sipeed/RV-Debugger-BL702/(threads)

Thread 1 (2021-07-21):

如何调试bl602呢

HoGC, 2021-07-21:
使用RV-Debugger-BL702对bl602进行调试，但是在打开OpenOCD时得到了`IR capture error at bit 5, saw 0x01 not 0x...3`的错误
```
Open On-Chip Debugger 0.10.0+dev (SiFive OpenOCD 0.10.0-2019.08.2)
Licensed under GNU GPL v2
For bug reports:
        https://github.com/sifive/freedom-tools/issues
adapter speed: 2000 kHz
Ready for Remote Connections
Info : clock speed 2000 kHz
Info : JTAG tap: riscv.cpu tap/device found: 0x20000c05 (mfg: 0x602 (<unknown>), part: 0x0000, ver: 0x2)
Error: IR capture error at bit 5, saw 0x01 not 0x...3
Warn : Bypassing JTAG setup events due to errors
Error: failed write at 0x10, status=1
Error: failed write at 0x10, status=1
Error: failed write at 0x10, status=1
Error: failed read at 0x10, status=1
Info : Listening on port 3333 for gdb connections
Info : Listening on port 6666 for tcl connections
Info : Listening on port 4444 for telnet connections
```

Thread 6 (2022-01-20):

Rv BL702 can't connect to target over Openocd

thinhx2, 2022-01-20:
It still stuck at : haven't made progress in mpsse flash()

Rv BL702(programmer)
![Uploading IMG_20220120_194508_489.jpg…]()
+ openocd 0.11 + STM32F103 (target)

RV lite CH552T working fine

thinhx2, 2022-01-20:
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

Here is image

thinhx2, 2022-01-20:
Error notice when i remove programmer, not problem

thinhx2, 2022-01-22:
'/home/thinhx2/xpack-openocd-0.11.0-3/bin/openocd'  -f '/home/thinhx2/Desktop/tool-openocd-gd32v/share/openocd/scripts/interface/ftdi/sipeed-rv-debugger.cfg'  -f '/home/thinhx2/xpack-openocd-0.11.0-3/scripts/target/stm32f1x.cfg' -c "adapter speed 1000" -c "init;program /media/thinhx2/A44CFDC04CFD8CF4/Users/thinhx2/Documents/32/103c8/build/103c8.hex verify reset;exit"
xPack OpenOCD x86_64 Open On-Chip Debugger 0.11.0+dev (2021-12-07-17:30)
Licensed under GNU GPL v2
For bug reports, read
	http://openocd.org/doc/doxygen/bugs.html
DEPRECATED! use 'adapter driver' not 'interface'
DEPRECATED! use 'ftdi vid_pid' not 'ftdi_vid_pid'
DEPRECATED! use 'ftdi layout_init' not 'ftdi_layout_init'
DEPRECATED! use 'ftdi layout_signal' not 'ftdi_layout_signal'
Info : DEPRECATED target event trace-config; use TPIU events {pre,post}-{enable,disable}
adapter speed: 1000 kHz

Info : clock speed 1000 kHz
Warn : Haven't made progress in mpsse_flush() for 2001ms.
Warn : Haven't made progress in mpsse_flush() for 4001ms.
Warn : Haven't made progress in mpsse_flush() for 8001ms.
Warn : Haven't made progress in mpsse_flush() for 16001ms.
Warn : Haven't made progress in mpsse_flush() for 32001ms.

thinhx2, 2022-01-22:
Seem like with target command  (like stm32f1x.cfg) debugger will disconnect. Same problem with platformIO, Longan Nano

Closed 2022-01-22.

Thread 8 (2022-02-01):

USB enumeration issues

chiplet, 2022-02-01:
I'm experiencing USB enumeration issues on the Tang Nano 1K, 4K, and 9K boards. It seems that they use the same chip and presumably also the same firmware as this project so I'm reporting it here. Correct me if I'm wrong.

The problem is that when I try to connect the programmer to my computer over a USB hub, it fails to enumerate.

```
[29332.909014] usb 7-1.2: new full-speed USB device number 8 using xhci_hcd
[29338.196264] usb 7-1.2: device descriptor read/64, error -71
[29343.532540] usb 7-1.2: device descriptor read/64, error -71
[29343.722499] usb 7-1.2: new full-speed USB device number 9 using xhci_hcd
[29348.862626] usb 7-1.2: device descriptor read/64, error -71
[29354.196037] usb 7-1.2: device descriptor read/64, error -71
[29354.302915] usb 7-1-port2: attempt power cycle
[29354.916045] usb 7-1.2: new full-speed USB device number 10 using xhci_hcd
[29360.086242] xhci_hcd 0000:0a:00.3: Timeout while waiting for setup device command
[29365.419676] xhci_hcd 0000:0a:00.3: Timeout while waiting for setup device command
[29365.626240] usb 7-1.2: device not accepting address 10, error -62
[29365.709582] usb 7-1.2: new full-speed USB device number 11 using xhci_hcd
[29365.709791] usb 7-1.2: Device not responding to setup address.
[29365.916323] usb 7-1.2: Device not responding to setup address.
[29366.123016] usb 7-1.2: device not accepting address 11, error -71
[29366.123294] usb 7-1-port2: unable to enumerate USB device
```

This also happens on the front-panel USB hubs if there are other USB devices connected to the adjacent ports. However, if I unplug all other devices from the front panel it successfully enumerates again.

Enumeration works fine when directly connecting to USB ports in the motherboard.

I haven't experienced any enumeration issues with my other USB devices on these hubs so it seems like the issue related to the BL702 implementation.

securez, 2024-09-15:
Hi, the last time I checked it, seems to be related with the USB bMaxPower configuration, seems to be set at 90mA, It's a bit low for power up Tang Nano 4K I thing. I can test if the change solves the problem, but seems to me that this repository is stalled for a long time. If he project is dead I don't want to waste my time if nobody is reviewing the PR and resolving the issues.

CheemsThx, 2025-03-25:
有没有可能是USB硬件设计问题,阻抗没做好匹配导致抗干扰性能太差

Thread 11 (2022-04-24):

No Setup/Hold time on TDI / TMS

GideonZ, 2022-04-24:
With my purchased Sipeed RV Debugger Plus, which seems to use this firmware, I am not getting any successful JTAG connection using OpenOCD.

One issue is that the setup and hold times on TDI and TMS are near zero. This is wrong!

TDI and TCK toggle AT THE SAME TIME. Even more so, TDI / TMS also change on the falling edge of TCK.  I did not expect this, and it is highly suspicious.

Please fix, as this adapter is totally unusable with a timing like this.

robertlipe, 2022-05-12:
** This is a fly-by comment. I don't technically contain any relevant experience with this project, except as a user. (They work OK on the devices I've used...) I was looking at the source and something caught my eye that may be relevant.

In the main source directory of this app, there are two versions of the source code for the main application. I think they share a common ancestor, but it's not clear which is the newest or what the hardware actually shipped with. Just reading the code and the git history, the trunk contains a newer version (10 months vs. 11) of that main app that works hard to avoid code that *was* there that added delays in transitions like this.

Try replacing [jtag_process.c](https://github.com/sipeed/RV-Debugger-BL702/blob/main/examples/usb/usb2uartjtag/jtag_process.c) with jtag_process.c.gowin. There are a lot of changes, but all that DELAY stuff that is missing might actually be helpful to this case.  It's uncomfortable to busy-wait in an interrupt handler, but that interrupt handler should be most of what that device is doing. It'd cause USB and serial overruns, but it shouldn't be DOING either of those while JTAGGing, right?

Maybe you graft those definitions and uses into the trunk and create a PR.

At the very least, these DELAY_HIGH and DELAY_LOW call sites mark the places in the code create edges in those signals when starting and ending transitions, so it may be helpful to add yet more delays.

Sidebar: you may find #3 handy.

Good luck.

Thread 12 (2022-04-24):

OpenOCD: No progress with mpsse_flush( )

GideonZ, 2022-04-24:
The mpsse implementation seems to be buggy. I cannot get this adapter to reliably work with OpenOCD. At times OpenOCD just hangs with the message "Haven't made progress in mpsse_flush()..."

This seems to happen more with OpenOCD 0.11.0-4, but I have also seen it happen with 0.10.0, which comes with Ubuntu (18.04 LTS).

robertlipe, 2022-05-12:
For a way to reliably crash the device (admittedly a slightly different BL602...) see https://bbs.bouffalolab.com/d/118-restore-bl706-evb-mb-ability-to-upload-code/8 for a similar report.

I don't suspect this lands on Sipeed as much as it does Bouffalo and/or OpenOCD.

zqb-all, 2023-02-21:
openocd log:
```
Debug: 14 30 command.c:166 script_debug(): command - adapter driver ftdi
Debug: 15 31 command.c:166 script_debug(): command - ftdi vid_pid 0x0403 0x6010
Debug: 16 35 command.c:166 script_debug(): command - transport select jtag
Debug: 17 36 command.c:166 script_debug(): command - ftdi layout_init 0x0008 0x001b
Debug: 18 38 command.c:166 script_debug(): command - ftdi layout_signal nSRST -oe 0x0020 -data 0x0020
Debug: 19 39 command.c:166 script_debug(): command - adapter speed 1200
Debug: 20 40 adapter.c:176 adapter_config_khz(): handle adapter khz
Debug: 21 41 adapter.c:140 adapter_khz_to_speed(): convert khz to adapter specific speed value
Debug: 22 43 adapter.c:140 adapter_khz_to_speed(): convert khz to adapter specific speed value
Debug: 23 44 command.c:166 script_debug(): command - bindto 0.0.0.0
Debug: 24 45 command.c:166 script_debug(): command - gdb_port 1025
Debug: 25 46 command.c:166 script_debug(): command - jtag newtap riscv cpu -irlen 5 -expected-id 0x10000BF6
Debug: 26 50 tcl.c:568 jim_newtap_cmd(): Creating New Tap, Chip: riscv, Tap: cpu, Dotted: riscv.cpu, 4 params
Debug: 27 52 tcl.c:593 jim_newtap_cmd(): Processing option: -irlen
Debug: 28 53 tcl.c:593 jim_newtap_cmd(): Processing option: -expected-id
Debug: 29 54 core.c:1468 jtag_tap_init(): Created Tap: riscv.cpu @ abs position 0, irlen 5, capture: 0x1 mask: 0x3
Debug: 30 56 command.c:166 script_debug(): command - target create riscv.cpu.0 riscv -chain-position riscv.cpu
Debug: 31 57 target.c:2214 target_free_all_working_areas_restore(): freeing all working areas
Debug: 32 59 riscv.c:356 riscv_create_target(): riscv_create_target()
Debug: 33 60 command.c:166 script_debug(): command - riscv.cpu.0 configure -work-area-phys 0x20000000 -work-area-size 4096 -work-area-backup 0
Debug: 34 64 target.c:2214 target_free_all_working_areas_restore(): freeing all working areas
Debug: 35 66 target.c:2214 target_free_all_working_areas_restore(): freeing all working areas
Debug: 36 67 target.c:2214 target_free_all_working_areas_restore(): freeing all working areas
Debug: 37 68 command.c:166 script_debug(): command - init
Debug: 38 69 command.c:166 script_debug(): command - target init
Debug: 39 70 command.c:166 script_debug(): command - target names
Debug: 40 71 command.c:166 script_debug(): command - riscv.cpu.0 cget -event gdb-flash-erase-start
Debug: 41 72 command.c:166 script_debug(): command - riscv.cpu.0 configure -event gdb-flash-erase-start reset init
Debug: 42 74 command.c:166 script_debug(): command - riscv.cpu.0 cget -event gdb-flash-write-end
Debug: 43 76 command.c:166 script_debug(): command - riscv.cpu.0 configure -event gdb-flash-write-end reset halt
Debug: 44 80 command.c:166 script_debug(): command - riscv.cpu.0 cget -event gdb-attach
Debug: 45 81 command.c:166 script_debug(): command - riscv.cpu.0 configure -event gdb-attach halt 1000
Debug: 46 83 target.c:1671 handle_target_init_command(): Initializing targets...
Debug: 47 84 riscv.c:369 riscv_init_target(): riscv_init_target()
Debug: 48 85 semihosting_common.c:130 semihosting_common_init():
Debug: 49 86 ftdi.c:742 ftdi_initialize(): ftdi interface using shortest path jtag state transitions
Debug: 50 110 mpsse.c:423 mpsse_purge(): -
Debug: 51 111 mpsse.c:704 mpsse_loopback_config(): off
Debug: 52 112 mpsse.c:749 mpsse_set_frequency(): target 1200000 Hz
Debug: 53 113 mpsse.c:710 mpsse_set_divisor(): 4
Debug: 54 114 mpsse.c:773 mpsse_set_frequency(): actually 1200000 Hz
Debug: 55 115 adapter.c:140 adapter_khz_to_speed(): convert khz to adapter specific speed value
Debug: 56 116 adapter.c:144 adapter_khz_to_speed(): have adapter set up
Debug: 57 118 mpsse.c:749 mpsse_set_frequency(): target 1200000 Hz
Debug: 58 119 mpsse.c:710 mpsse_set_divisor(): 4
Debug: 59 119 mpsse.c:773 mpsse_set_frequency(): actually 1200000 Hz
Debug: 60 120 adapter.c:140 adapter_khz_to_speed(): convert khz to adapter specific speed value
Debug: 61 122 adapter.c:144 adapter_khz_to_speed(): have adapter set up
Info : 62 123 adapter.c:104 adapter_init(): clock speed 1200 kHz
Debug: 63 126 openocd.c:143 handle_init_command(): Debug Adapter init complete
Debug: 64 127 command.c:166 script_debug(): command - transport init
Debug: 65 128 transport.c:230 handle_transport_init(): handle_transport_init
Debug: 66 130 core.c:824 jtag_add_reset(): SRST line released
Debug: 67 130 core.c:849 jtag_add_reset(): TRST line released
Debug: 68 131 core.c:322 jtag_call_event_callbacks(): jtag event: TAP reset
Debug: 69 133 command.c:166 script_debug(): command - jtag arp_init
Debug: 70 134 target.c:1857 target_call_event_callbacks(): target event 0 (gdb-halt) for core riscv.cpu.0
Debug: 71 135 target.c:3072 handle_target(): [riscv.cpu.0] target_poll() -> -4, next attempt in 100ms
Debug: 72 137 core.c:1503 jtag_init_inner(): Init JTAG chain
Debug: 73 137 core.c:322 jtag_call_event_callbacks(): jtag event: TAP reset
Debug: 74 139 core.c:1228 jtag_examine_chain(): DR scan interrogation for IDCODE/BYPASS
Debug: 75 142 core.c:322 jtag_call_event_callbacks(): jtag event: TAP reset
Warn : 76 2144 mpsse.c:917 mpsse_flush(): Haven't made progress in mpsse_flush() for 2001ms.
Warn : 77 4144 mpsse.c:917 mpsse_flush(): Haven't made progress in mpsse_flush() for 4001ms.
Warn : 78 8144 mpsse.c:917 mpsse_flush(): Haven't made progress in mpsse_flush() for 8001ms.
Warn : 79 16144 mpsse.c:917 mpsse_flush(): Haven't made progress in mpsse_flush() for 16001ms.
Warn : 80 32144 mpsse.c:917 mpsse_flush(): Haven't made progress in mpsse_flush() for 32001ms.
Warn : 81 64144 mpsse.c:917 mpsse_flush(): Haven't made progress in mpsse_flush() for 64001ms.
Warn : 82 128144 mpsse.c:917 mpsse_flush(): Haven't made progress in mpsse_flush() for 128001ms.
```

sipeed usb-jtag/ttl and sipeed rv-debugger lite can work, only sipeed rv-debugger plus have this issue.

Can anyone give me some advice?

GideonZ, 2023-02-21:
I had the same issue. I also measured the JTAG signals with an
oscilloscope. It was nonsense; TMS changing on both the rising and falling
edges. I reported it to the seller and dumped it in the trash.

Been using an FTDI FT2232H since without issues.

thecasterian, 2023-02-28:
So this is why I could not use this debugger in PlatformIO...

thecasterian, 2023-02-28:
After **re-flashing** the debugger following the fixed instruction in https://github.com/sipeed/RV-Debugger-BL702/pull/15 it now works perfectly without such an error! The firmware initially uploaded on a new debugger might be somewhat broken.

Thread 14 (2022-08-28):

usb2uartjtag固件，uart使用不了

xulinkun, 2022-08-28:
调试板为 rv-debugger-plus，目标机器是sipeed nano，编译出来发现jtag能用，但是uart无通信。起初怀疑硬件的问题，但对比烧录sdk example下的usb2uart用例，uart通信正常，所以认定是固件bug，请排查一下。

luvletter2333, 2024-03-02:
把这一行注释掉，重新编译然后烧固件就行了，但是我还没测试jtag好不好使

https://github.com/sipeed/RV-Debugger-BL702/blob/cdc36a481b8d06be261e5094202ac9e313fa585c/firmware/app/usb2uartjtag/uart_interface.c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

这一行在 usb2dualuart下面是被注释掉了的

https://github.com/sipeed/RV-Debugger-BL702/blob/cdc36a481b8d06be261e5094202ac9e313fa585c/firmware/app/usb2dualuart/uart_interface.c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

小编也很好奇为什么

richardclli, 2024-05-17:
Fixed了
https://github.com/sipeed/RV-Debugger-BL702/pull/19

Closed 2024-10-31.

Thread 16 (2023-09-12):

reent.h: No such file or directory

lhmax2010, 2023-09-12:
我们依照这个方法在LicheePi4A的板子上面进行编译的

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

结果报错了
[ 97%] Building C object samples/usb2uartjtag/CMakeFiles/usb2uartjtag_bl702.elf.dir/home/debian/RV-Debugger-BL702/firmware/bl_mcu_sdk/bsp/bsp_common/platform/syscalls.c.obj
/home/debian/RV-Debugger-BL702/firmware/bl_mcu_sdk/bsp/bsp_common/platform/syscalls.c:1:10: fatal error: reent.h: No such file or directory
    1 | #include <reent.h>
      |          ^~~~~~~~~
compilation terminated.
make[3]: *** [samples/usb2uartjtag/CMakeFiles/usb2uartjtag_bl702.elf.dir/build.make:174: samples/usb2uartjtag/CMakeFiles/usb2uartjtag_bl702.elf.dir/home/debian/RV-Debugger-BL702/firmware/bl_mcu_sdk/bsp/bsp_common/platform/syscalls.c.obj] Error 1
make[3]: *** Waiting for unfinished jobs....
make[3]: Leaving directory '/home/debian/RV-Debugger-BL702/firmware/bl_mcu_sdk/build'
make[2]: *** [CMakeFiles/Makefile2:153: samples/usb2uartjtag/CMakeFiles/usb2uartjtag_bl702.elf.dir/all] Error 2
make[2]: Leaving directory '/home/debian/RV-Debugger-BL702/firmware/bl_mcu_sdk/build'
make[1]: *** [Makefile:91: all] Error 2
make[1]: Leaving directory '/home/debian/RV-Debugger-BL702/firmware/bl_mcu_sdk/build'
make: *** [Makefile:52: build] Error 2

能看下是什么原因么？

lhmax2010, 2023-09-12:
After remove the
echo "add_compile_options(-specs=picolibc.specs)" >> tools/cmake/compiler_flags.cmake
echo "add_link_options(-specs=picolibc.specs)" >> tools/cmake/compiler_flags.cmake
And then we move to compile with the latest riscv64 toolchain, it compile success.
But we met the new issue with link

/home/linhao/RISC-V/Codes/GNU_Tool/toolchain/lib/gcc/riscv64-unknown-elf/12.2.0/../../../../riscv64-unknown-elf/bin/ld: /home/linhao/RISC-V/Codes/GNU_Tool/toolchain/lib/gcc/riscv64-unknown-elf/12.2.0/../../../../riscv64-unknown-elf/lib/libc_nano.a(lib_a-malloc.o): ABI is incompatible with that of the selected emulation:
  target emulation `elf64-littleriscv' does not match `elf32-littleriscv'
/home/linhao/RISC-V/Codes/GNU_Tool/toolchain/lib/gcc/riscv64-unknown-elf/12.2.0/../../../../riscv64-unknown-elf/bin/ld: failed to merge target specific data of file /home/linhao/RISC-V/Codes/GNU_Tool/toolchain/lib/gcc/riscv64-unknown-elf/12.2.0/../../../../riscv64-unknown-elf/lib/libc_nano.a(lib_a-malloc.o)
/home/linhao/RISC-V/Codes/GNU_Tool/toolchain/lib/gcc/riscv64-unknown-elf/12.2.0/../../../../riscv64-unknown-elf/bin/ld: /home/linhao/RISC-V/Codes/GNU_Tool/toolchain/lib/gcc/riscv64-unknown-elf/12.2.0/../../../../riscv64-unknown-elf/lib/libc_nano.a(lib_a-memcpy-asm.o): ABI is incompatible with that of the selected emulation:
  target emulation `elf64-littleriscv' does not match `elf32-littleriscv'
/home/linhao/RISC-V/Codes/GNU_Tool/toolchain/lib/gcc/riscv64-unknown-elf/12.2.0/../../../../riscv64-unknown-elf/bin/ld: failed to merge target specific data of file /home/linhao/RISC-V/Codes/GNU_Tool/toolchain/lib/gcc/riscv64-unknown-elf/12.2.0/../../../../riscv64-unknown-elf/lib/libc_nano.a(lib_a-memcpy-asm.o)
/home/linhao/RISC-V/Codes/GNU_Tool/toolchain/lib/gcc/riscv64-unknown-elf/12.2.0/../../../../riscv64-unknown-elf/bin/ld: /home/linhao/RISC-V/Codes/GNU_Tool/toolchain/lib/gcc/riscv64-unknown-elf/12.2.0/../../../../riscv64-unknown-elf/lib/libc_nano.a(lib_a-memset.o): ABI is incompatible with that of the selected emulation:
  target emulation `elf64-littleriscv' does not match `elf32-littleriscv'

It seemed that the project has something conflict with the 64bits riscv toolchain.

Bestoa, 2024-09-27:
换编译器，装的版本不能用，下个FreedomStudio

a7-github, 2025-01-11:
solved in https://github.com/sipeed/RV-Debugger-BL702/issues/21

Thread 17 (2023-09-17):

Can't program GW1NZ-LV1 FPGA with published code.

dmolinagarcia, 2023-09-17:
Hi. I'm struggling to fix an issue I'm having with the published usb2uartjtag code.

I have a Tang Nano 1k, with a BL702 on board. I desoldered both the Bl702 and the GW1NZ FPGA, and transfered them to my own PCB, that replicates the TANG NANO schematich, but with severl BL and GW1NZ pins exposed via pin headers, as well as some additional stuff.

I can program the FPGA with the current BL702 firmware. Both the BL and the FPGA behave as expected, same as when they were on the Tang Nano PCB. However, after building the USB2UARTJTAG firmware for the Bl702, it fails to program the FPGA.

With this firmware, the Bl702 is properly detected as a FTDI device. And the gowin programmer works. However, it ends up with an error code, and the FPGA won't wake up. This firmware can program the SRAM properly though, but it fails to program the flash.

Reverting to the original firmware allows me to reprogram the FPGA, with no issues.

In order to discard any issues while soldering, I build 3 boards, from 3 Tang Nano. Same behaviour in the 3 of them. So I'm pretty sure my issue is caused by some firmware error I'm failing to detect.

I've capture the full JTAG operation with a logic analizer. Both captures are pretty much identical, except on two points.

After erasing the Emb.Flash, on the original firmware the status is 0x39020, but with the github code, I get 0x19020. This is bit 17 being changed, however, bit 17 does not show in the gowin documentation!

Also, at the end of the programming cycle, instead of 0x39020, I get 0x11426 or 0x15422.

Everything else is the same in the JTAG conversation.

Another difference is the time it take to complete the programing. On the original firmware a bit below 5 seconds. With the compiled code from github, it goes up to 7-8 seconds. I'm guessing the issue is cause by some timing issue, but I'm still not able to pinpoint it.

If needed, I can provide the full JTAG capture, my pcb schematichs, anything you may need if you're able to look into this.

Many thanks.

dmolinagarcia, 2023-09-19:
Hi,

It turned out, I wasn't compiling the right code. I had to use the jtag_process.c.gowin file which has several differences with the jtag_process.c file.

I'll provide more details later, but I've managed to program my gowin fpga now.

dmolinagarcia, 2023-09-19:
More details

Indeed, in order to program gowin devices, it seems the jtag_process.c.gowin has to be used, instead of the jtag_process.c.

However, when exchanging those files, disable_irq and enable_irq, called from within the jtag process, are not found. I added this to the jtag_process.c file:

```
__ALWAYS_STATIC_INLINE void enable_irq(void)
{
    __ASM volatile("csrs mstatus, 8");
}

__ALWAYS_STATIC_INLINE void disable_irq(void)
{
    __ASM volatile("csrc mstatus, 8");
}
```

Also, I get a linker error:

```
c:/users/daniel.molina/appdata/roaming/c-sky/cdkrepo/toolchain/xtgccelfnewlib/v2.6.1/r/bin/../lib/gcc/riscv64-unknown-elf/10.2.0/../../../../riscv64-unknown-elf/bin/ld.exe: region RAM overflowed with stack
c:/users/daniel.molina/appdata/roaming/c-sky/cdkrepo/toolchain/xtgccelfnewlib/v2.6.1/r/bin/../lib/gcc/riscv64-unknown-elf/10.2.0/../../../../riscv64-unknown-elf/bin/ld.exe: section .system_ram_data_region VMA [0000000022018000,000000002201bfff] overlaps section .stack_dummy VMA [000000002201741c,000000002201841b]
c:/users/daniel.molina/appdata/roaming/c-sky/cdkrepo/toolchain/xtgccelfnewlib/v2.6.1/r/bin/../lib/gcc/riscv64-unknown-elf/10.2.0/../../../../riscv64-unknown-elf/bin/ld.exe: region `dtcm_memory' overflowed by 1052 bytes
collect2.exe: error: ld returned 1 exit status
```

So I need to amend the linker settings, in the bl702_flash.ld file from

```
MEMORY
{
    xip_memory  (rx)  : ORIGIN = 0x23000000, LENGTH = 1024K
    itcm_memory (rx)  : ORIGIN = 0x22014000, LENGTH = 8K
    dtcm_memory (rx)  : ORIGIN = 0x22016000, LENGTH = 8K
    ram_memory  (!rx) : ORIGIN = 0x22018000, LENGTH = 88K
    hbn_memory  (rx)  : ORIGIN = 0x40010000, LENGTH = 0xE00     /* hbn ram 4K used 3.5K*/
}
```

to

```
MEMORY
{
    xip_memory  (rx)  : ORIGIN = 0x23000000, LENGTH = 1024K
    itcm_memory (rx)  : ORIGIN = 0x22014000, LENGTH = 8K
    dtcm_memory (rx)  : ORIGIN = 0x22016000, LENGTH = 12K
    ram_memory  (!rx) : ORIGIN = 0x22019000, LENGTH = 84K
    hbn_memory  (rx)  : ORIGIN = 0x40010000, LENGTH = 0xE00     /* hbn ram 4K used 3.5K*/
}
```

Closed 2023-10-19.

Thread 20 (2024-06-04):

FTDI emulation in violationg the driver License agreement

AnttiLukats, 2024-06-04:
It is not legally OK to emulate FTDI devices, as the end user has to accept the FTDI License that prohibits the driver use with not genuine FTDI products.

mlapaj, 2025-02-27:
What about using this in Linux ? I have not accepted any other (like FTDI) license than GPL/LGPL ?

Thread 25 (2025-05-20):

GOWIN jtag_process.c - Undefined reference to disable_irq();

mrozy2006, 2025-05-20:
Hi, I cannot compile the usb2uartjtag version for Gowin FPGA, because I am getting a linker error on line 418 in jtag_process.c. What do I do in that case?

Closed 2025-05-20.
