sipeed/RV-Debugger-BL702/hardware/BL702_USB2JTAG_3610_asm.pdf

C8

# ANT1

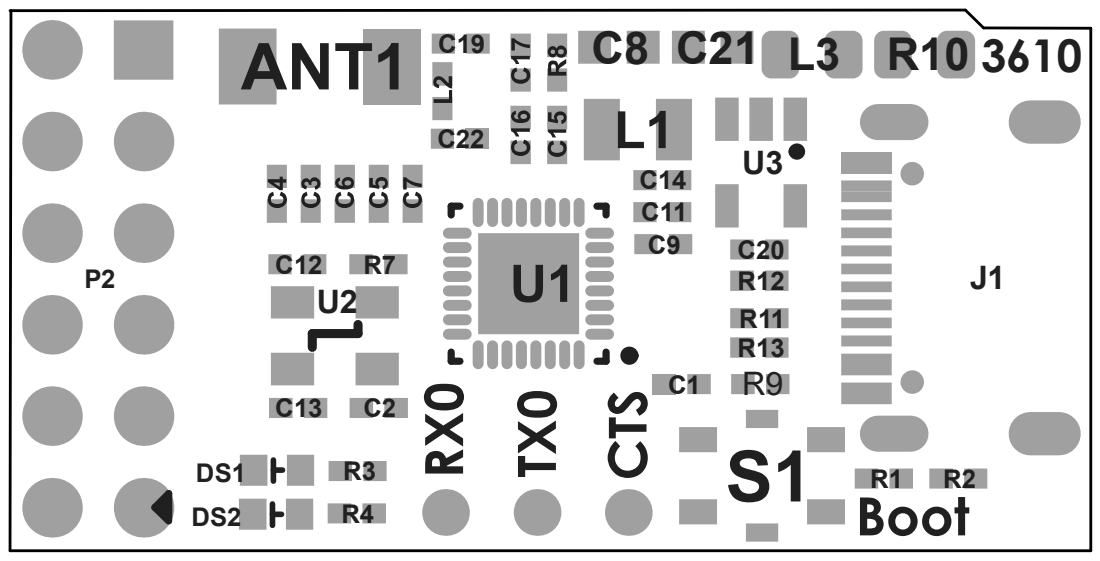
[picture p3: page 1]
