sipeed/RV-Debugger-BL702/firmware/app/usb2dualuart/dev_cfg.h

#pragma once

#include "hal_gpio.h"

#define UART0_TXD_PIN GPIO_PIN_15
#define UART0_RXD_PIN GPIO_PIN_0
#define UART0_DTR_PIN GPIO_PIN_1
#define UART0_RTS_PIN GPIO_PIN_2

#define UART1_TXD_PIN GPIO_PIN_26
#define UART1_RXD_PIN GPIO_PIN_27
#define UART1_DTR_PIN GPIO_PIN_28
#define UART1_RTS_PIN GPIO_PIN_24

#define LED0_PIN GPIO_PIN_9
#define LED1_PIN GPIO_PIN_17
