sipeed/RV-Debugger-BL702/(commit log)

2021-07-18 1. first usable bl702 burn gowin
    [jtag_process.c, main.c, uart_interface.c]
2022-03-01 make sdk as submodule & move and update code & update workflows
    [if_702_hack.cfg, if_bflb_dbg.cfg, if_bflb_link.cfg, if_ft2232d.cfg, if_jlink.cfg, if_usb_dbg.cfg, image-loader.cfg, sifive-e2-ftdi.cfg]
2024-05-17 Fixed COM port DMA init.
    [uart_interface.c]
